xKraZx/Pol-Deck/hardware/Deck_Mainboard/Deck_Mainboard.kicad_pcb

## KiCad design hardware/Deck_Mainboard/Deck_Mainboard.kicad_pcb (2026-08-24)

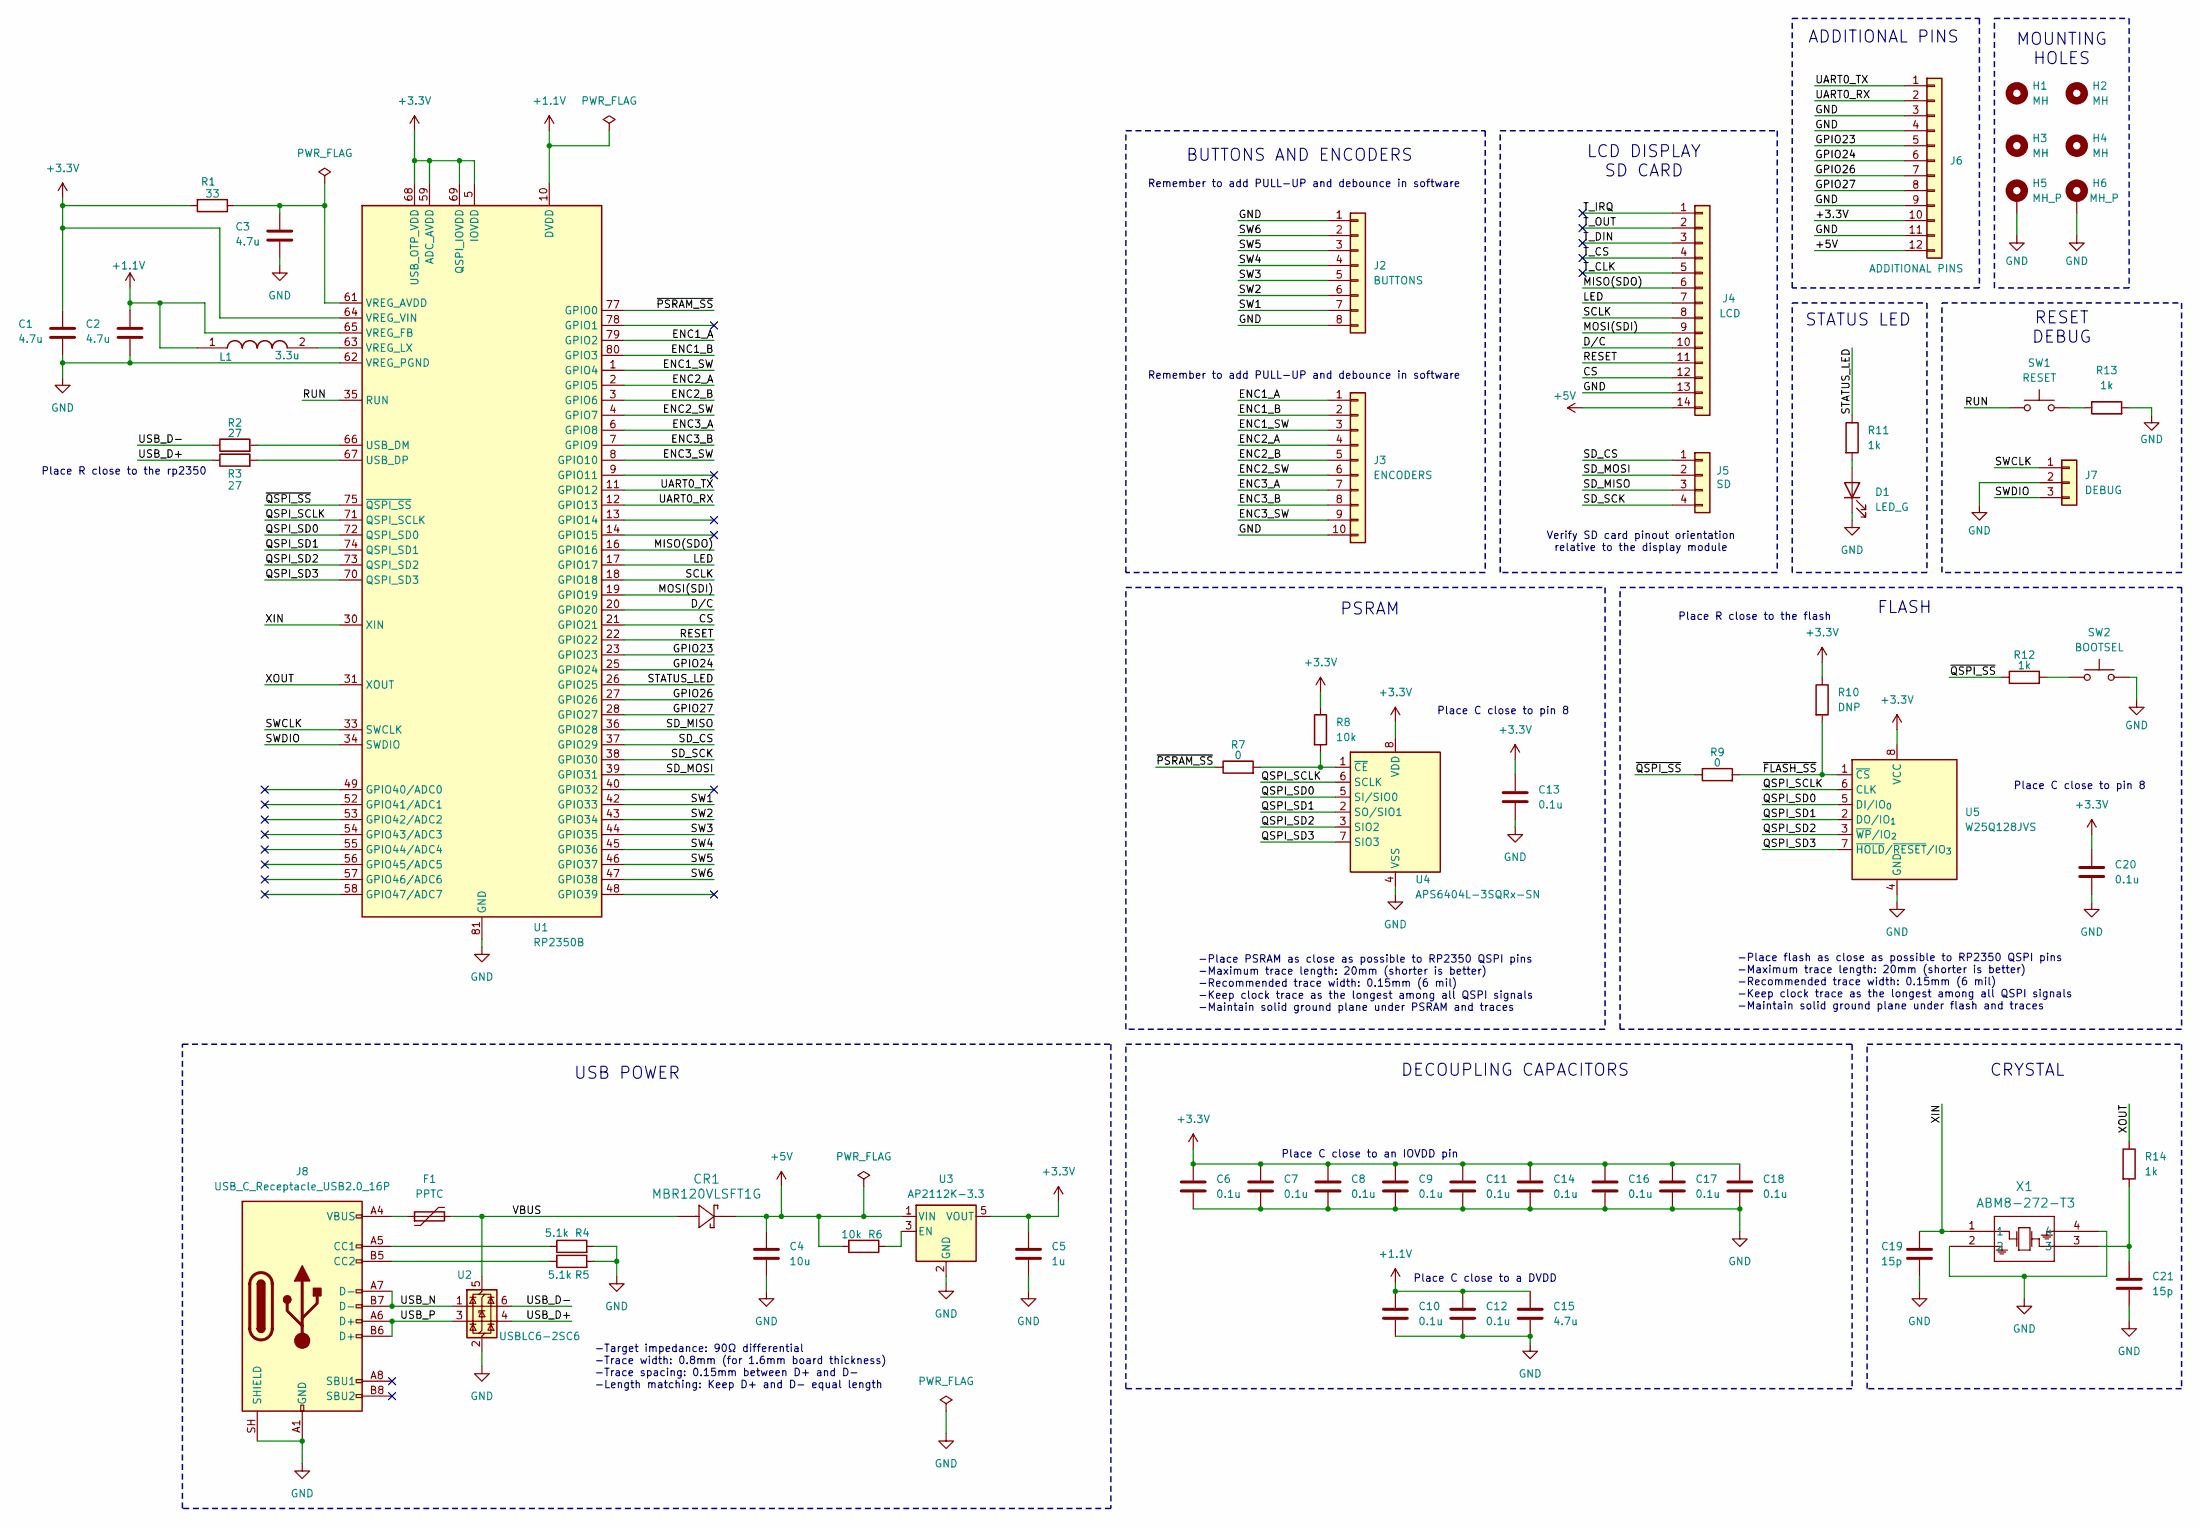
[picture p1: schematic Deck_Mainboard.kicad_sch]

Parts:
C1, C2, C3, C15: 4.7u; C_0402_1005Metric_Pad0.74x0.62mm_HandSolder
C4: 10u; C_0402_1005Metric_Pad0.74x0.62mm_HandSolder
C5: 1u; C_0402_1005Metric_Pad0.74x0.62mm_HandSolder
C6, C7, C8, C9, C10, C11, C12, C13, C14, C16, C17, C18, C20: 0.1u; C_0402_1005Metric_Pad0.74x0.62mm_HandSolder
C19, C21: 15p; C_0402_1005Metric_Pad0.74x0.62mm_HandSolder
CR1: MBR120VLSFT1G
D1: LED_G; LED_0603_1608Metric_Pad1.05x0.95mm_HandSolder
F1: PPTC; Fuse_1812_4532Metric_Pad1.30x3.40mm_HandSolder
H1, H2, H3, H4: MH; MountingHole_3.2mm_M3
H5, H6: MH_P; MountingHole_3.2mm_M3_Pad
J2: BUTTONS; PinHeader_1x08_P2.54mm_Vertical
J3: ENCODERS; PinHeader_1x10_P2.54mm_Vertical
J4: LCD; PinHeader_1x14_P2.54mm_Vertical
J5: SD; PinHeader_1x04_P2.54mm_Vertical
J6: ADDITIONAL PINS; PinHeader_1x12_P2.54mm_Vertical
J7: DEBUG; PinHeader_1x03_P2.54mm_Vertical
J8: USB_C_Receptacle_USB2.0_16P; USB_C_vertical
L1: 3.3u; AOTAB201610S3R3101T; Manufacturer_Part_Number AOTA-B201610S3R3-101-T
R1: 33; R_0402_1005Metric_Pad0.72x0.64mm_HandSolder
R2, R3: 27; R_0402_1005Metric_Pad0.72x0.64mm_HandSolder
R4, R5: 5.1k; R_0402_1005Metric_Pad0.72x0.64mm_HandSolder
R6, R8: 10k; R_0402_1005Metric_Pad0.72x0.64mm_HandSolder
R7, R9: 0; R_0402_1005Metric_Pad0.72x0.64mm_HandSolder
R10: DNP; R_0402_1005Metric_Pad0.72x0.64mm_HandSolder
R11, R12, R13, R14: 1k; R_0402_1005Metric_Pad0.72x0.64mm_HandSolder
SW1: RESET; SW_Push_1P1T_NO_E-Switch_TL3301NxxxxxG
SW2: BOOTSEL; SW_Push_1P1T_NO_E-Switch_TL3301NxxxxxG
U1: RP2350B; QFN-80-1EP_10x10mm_P0.4mm_EP3.4x3.4mm
U2: USBLC6-2SC6; SOT-23-6
U3: AP2112K-3.3; SOT-23-5
U4: APS6404L-3SQRx-SN; SOIC-8_3.9x4.9mm_P1.27mm
U5: W25Q128JVS; SOIC-8_5.3x5.3mm_P1.27mm
X1: ABM8-272-T3; ABM8-272-T3_ABR

Connections:
+1.1V: C2.1, C10.1, C12.1, C15.1, L1.1, U1.10 (DVDD), U1.32 (DVDD), U1.51 (DVDD), U1.65 (VREG_FB)
+3.3V: C1.1, C5.1, C6.1, C7.1, C8.1, C9.1, C11.1, C13.1, C14.1, C16.1, C17.1, C18.1, C20.1, J6.10, R1.2, R8.1, R10.1, U1.5 (IOVDD), U1.15 (IOVDD), U1.24 (IOVDD), U1.29 (IOVDD), U1.41 (IOVDD), U1.50 (IOVDD), U1.59 (ADC_AVDD), U1.60 (IOVDD), U1.64 (VREG_VIN), U1.68 (USB_OTP_VDD), U1.69 (QSPI_IOVDD), U1.76 (IOVDD), U3.5 (VOUT), U4.8 (VDD), U5.8 (VCC)
+5V: C4.1, CR1.1, J4.14, J6.12, R6.2, U3.1 (VIN)
/CS: J4.12, U1.21 (GPIO21)
/D/C: J4.10, U1.20 (GPIO20)
/ENC1_A: J3.1, U1.79 (GPIO2)
/ENC1_B: J3.2, U1.80 (GPIO3)
/ENC1_SW: J3.3, U1.1 (GPIO4)
/ENC2_A: J3.4, U1.2 (GPIO5)
/ENC2_B: J3.5, U1.3 (GPIO6)
/ENC2_SW: J3.6, U1.4 (GPIO7)
/ENC3_A: J3.7, U1.6 (GPIO8)
/ENC3_B: J3.8, U1.7 (GPIO9)
/ENC3_SW: J3.9, U1.8 (GPIO10)
/GPIO23: J6.5, U1.23 (GPIO23)
/GPIO24: J6.6, U1.25 (GPIO24)
/GPIO26: J6.7, U1.27 (GPIO26)
/GPIO27: J6.8, U1.28 (GPIO27)
/LED: J4.7, U1.17 (GPIO17)
/MISO(SDO): J4.6, U1.16 (GPIO16)
/MOSI(SDI): J4.9, U1.19 (GPIO19)
/QSPI_SCLK: U1.71 (QSPI_SCLK), U4.6 (SCLK), U5.6 (CLK)
/QSPI_SD0: U1.72 (QSPI_SD0), U4.5 (SI/SIO0), U5.5 (DI/IO_{0})
/QSPI_SD1: U1.74 (QSPI_SD1), U4.2 (SO/SIO1), U5.2 (DO/IO_{1})
/QSPI_SD2: U1.73 (QSPI_SD2), U4.3 (SIO2), U5.3 (~WP/IO_{2})
/QSPI_SD3: U1.70 (QSPI_SD3), U4.7 (SIO3), U5.7 (~HOLD/~RESET/IO_{3})
/RESET: J4.11, U1.22 (GPIO22)
/RUN: SW1.1, U1.35 (RUN)
/SCLK: J4.8, U1.18 (GPIO18)
/SD_CS: J5.1, U1.37 (GPIO29)
/SD_MISO: J5.3, U1.36 (GPIO28)
/SD_MOSI: J5.2, U1.39 (GPIO31)
/SD_SCK: J5.4, U1.38 (GPIO30)
/STATUS_LED: R11.1, U1.26 (GPIO25)
/SW1: J2.7, U1.42 (GPIO33)
/SW2: J2.6, U1.43 (GPIO34)
/SW3: J2.5, U1.44 (GPIO35)
/SW4: J2.4, U1.45 (GPIO36)
/SW5: J2.3, U1.46 (GPIO37)
/SW6: J2.2, U1.47 (GPIO38)
/SWCLK: J7.1, U1.33 (SWCLK)
/SWDIO: J7.3, U1.34 (SWDIO)
/T_CLK: J4.5
/T_CS: J4.4
/T_DIN: J4.3
/T_IRQ: J4.1
/T_OUT: J4.2
/UART0_RX: J6.2, U1.12 (GPIO13)
/UART0_TX: J6.1, U1.11 (GPIO12)
/USB_D+: R3.1, U2.4 (I/O2)
/USB_D-: R2.1, U2.6 (I/O1)
/USB_N: J8.A7 (D-), J8.B7 (D-), U2.1 (I/O1)
/USB_P: J8.A6 (D+), J8.B6 (D+), U2.3 (I/O2)
/VBUS: CR1.2, F1.2, U2.5 (VBUS)
/XIN: C19.1, U1.30 (XIN), X1.1
/XOUT: R14.1, U1.31 (XOUT)
/~FLASH_SS: R9.2, R10.2, U5.1 (~CS)
/~PSRAM_SS: R7.1, U1.77 (GPIO0)
/~QSPI_SS: R9.1, R12.1, U1.75 (~QSPI_SS)
GND: C1.2, C2.2, C3.2, C4.2, C5.2, C6.2, C7.2, C8.2, C9.2, C10.2, C11.2, C12.2, C13.2, C14.2, C15.2, C16.2, C17.2, C18.2, C19.2, C20.2, C21.2, D1.1 (K), H5.1 (1_1), H6.1 (1_1), J2.1, J2.8, J3.10, J4.13, J6.3, J6.4, J6.9, J6.11, J7.2, J8.A1 (GND), J8.A12 (GND), J8.B1 (GND), J8.B12 (GND), J8.SH (SHIELD), R4.2, R5.2, R13.2, SW2.2, U1.62 (VREG_PGND), U1.81 (GND), U2.2 (GND), U3.2 (GND), U4.4 (VSS), U5.4 (GND), X1.2, X1.4
unnamed: C21.1, R14.2, X1.3
unnamed: D1.2 (A), R11.2
unnamed: F1.1, J8.A4 (VBUS), J8.A9 (VBUS), J8.B4 (VBUS), J8.B9 (VBUS)
unnamed: J8.A5 (CC1), R4.1
unnamed: J8.B5 (CC2), R5.1
unnamed: R12.2, SW2.1
unnamed: R13.1, SW1.2
unnamed: R2.2, U1.66 (USB_DM)
unnamed: R3.2, U1.67 (USB_DP)
unnamed: C3.1, R1.1, U1.61 (VREG_AVDD)
unnamed: L1.2, U1.63 (VREG_LX)
unnamed: R6.1, U3.3 (EN)
unnamed: R7.2, R8.2, U4.1 (~CE)

Notes on the sheet:
-Place PSRAM as close as possible to RP2350 QSPI pins -Maximum trace length: 20mm (shorter is better) -Recommended trace width: 0.15mm (6 mil) -Keep clock trace as the longest among all QSPI signals -Maintain solid ground plane under PSRAM and traces
ADDITIONAL PINS
USB POWER
LCD DISPLAY SD CARD
BUTTONS AND ENCODERS
Place R close to the rp2350
Verify SD card pinout orientation relative to the display module
CRYSTAL
Place C close to a DVDD
FLASH
PSRAM
Place R close to the flash
RESET DEBUG
-Place flash as close as possible to RP2350 QSPI pins -Maximum trace length: 20mm (shorter is better) -Recommended trace width: 0.15mm (6 mil) -Keep clock trace as the longest among all QSPI signals -Maintain solid ground plane under flash and traces
MOUNTING HOLES
Remember to add PULL-UP and debounce in software
Place C close to pin 8
DECOUPLING CAPACITORS
-Target impedance: 90Ω differential -Trace width: 0.8mm (for 1.6mm board thickness) -Trace spacing: 0.15mm between D+ and D- -Length matching: Keep D+ and D- equal length
STATUS LED
Place C close to an IOVDD pin

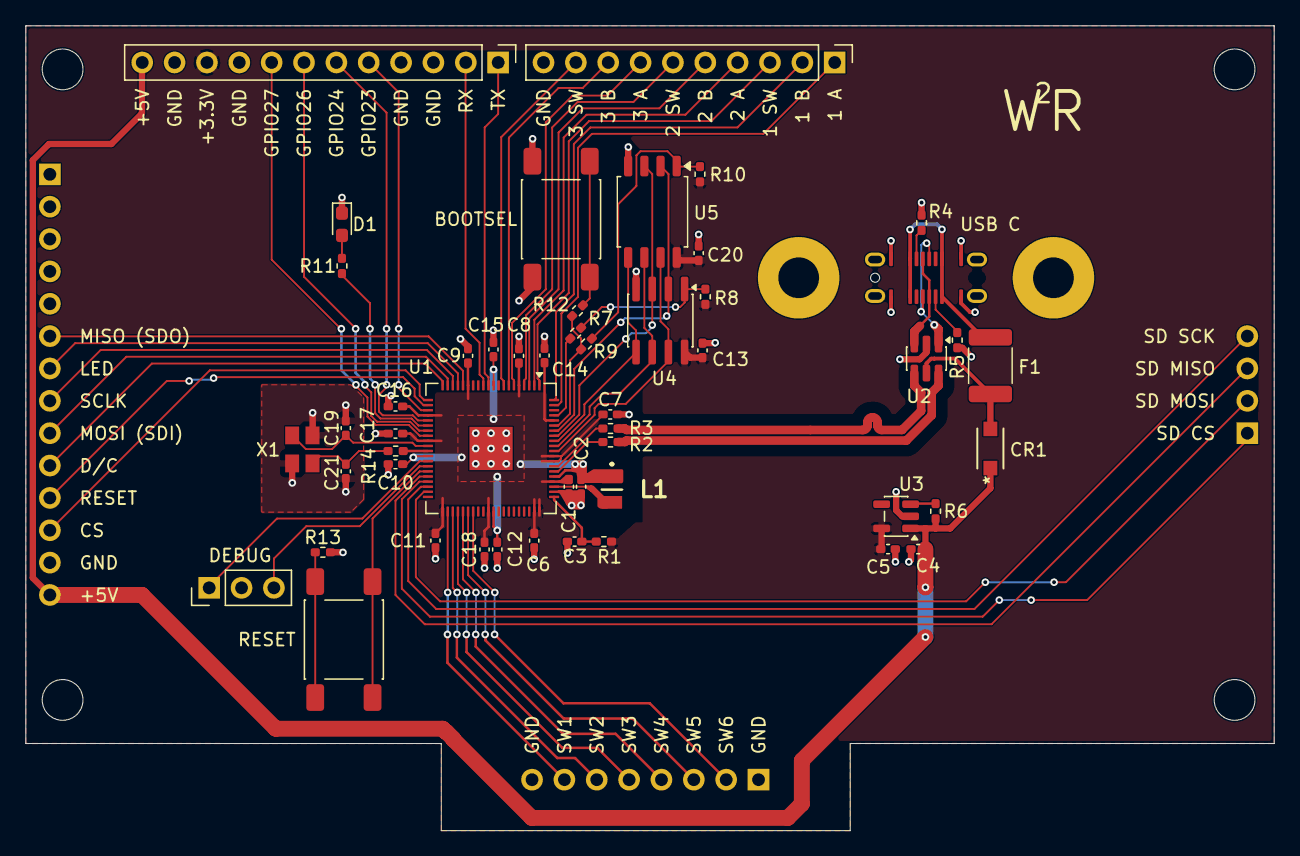
[picture p2: board Deck_Mainboard.kicad_pcb from above]

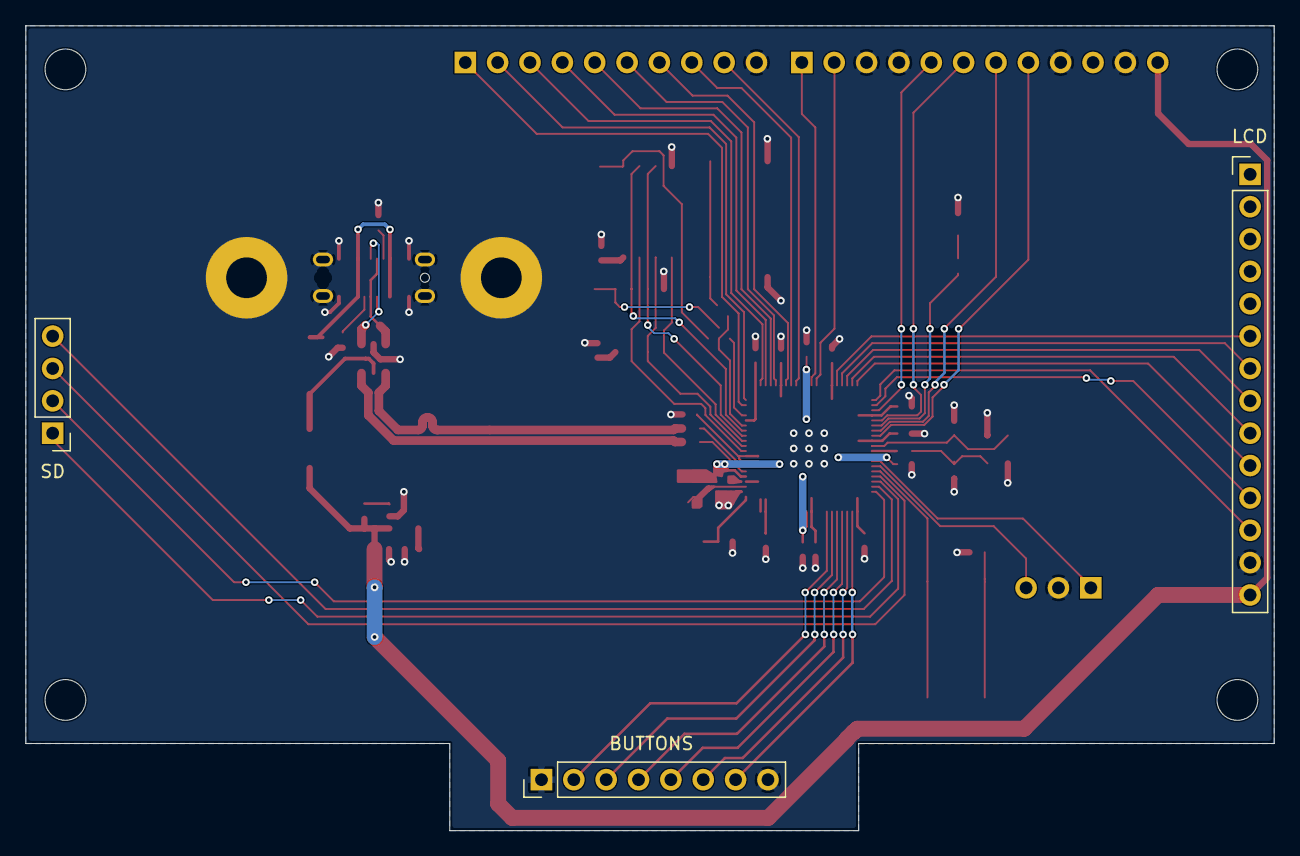
[picture p3: board Deck_Mainboard.kicad_pcb from below]

Board: 2 copper layers, 98.0 x 63.2 mm, 60 parts (3 on the bottom side), 68 nets.
