xKraZx/Pol-Deck/hardware/Deck_ButtonBoard/ButtonBoard/ButtonBoard.kicad_pcb

## KiCad design hardware/Deck_ButtonBoard/ButtonBoard/ButtonBoard.kicad_pcb (2026-08-24)

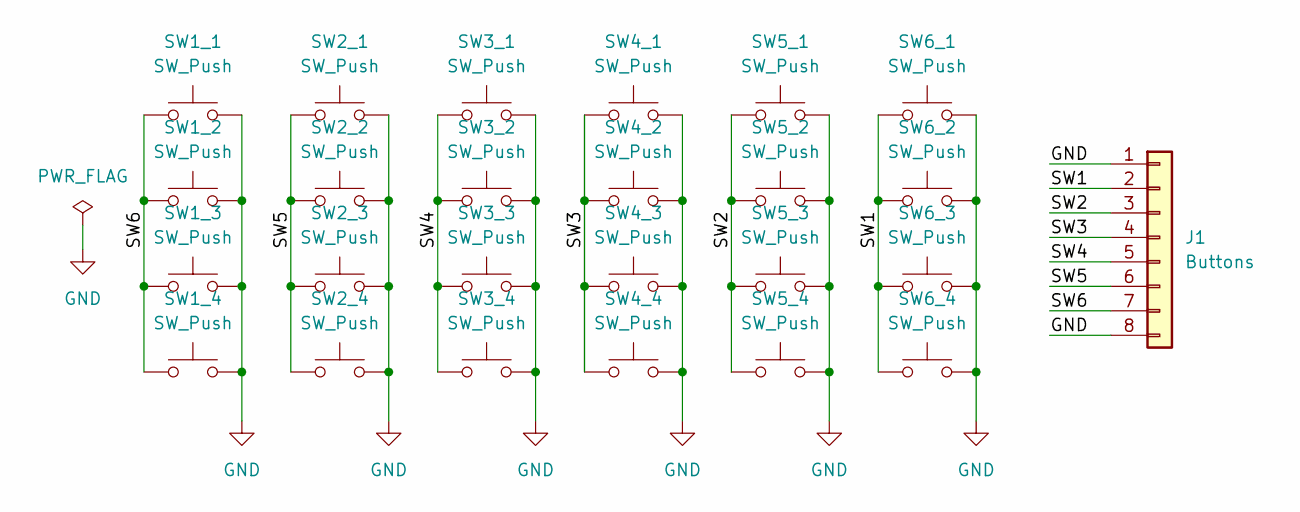
[picture p4: schematic ButtonBoard.kicad_sch]

Parts:
J1: Buttons; PinSocket_1x08_P2.54mm_Vertical
SW1_1, SW1_2, SW1_3, SW1_4, SW2_1, SW2_2, SW2_3, SW2_4, SW3_1, SW3_2, SW3_3, SW3_4, SW4_1, SW4_2, SW4_3, SW4_4, SW5_1, SW5_2, SW5_3, SW5_4, SW6_1, SW6_2, SW6_3, SW6_4: SW_Push; SW_Tactile_SPST_NO_Straight_CK_PTS636Sx25SMTRLFS

Connections:
/SW1: J1.2, SW6_1.1, SW6_2.1, SW6_3.1, SW6_4.1
/SW2: J1.3, SW5_1.1, SW5_2.1, SW5_3.1, SW5_4.1
/SW3: J1.4, SW4_1.1, SW4_2.1, SW4_3.1, SW4_4.1
/SW4: J1.5, SW3_1.1, SW3_2.1, SW3_3.1, SW3_4.1
/SW5: J1.6, SW2_1.1, SW2_2.1, SW2_3.1, SW2_4.1
/SW6: J1.7, SW1_1.1, SW1_2.1, SW1_3.1, SW1_4.1
GND: J1.1, J1.8, SW1_1.2, SW1_2.2, SW1_3.2, SW1_4.2, SW2_1.2, SW2_2.2, SW2_3.2, SW2_4.2, SW3_1.2, SW3_2.2, SW3_3.2, SW3_4.2, SW4_1.2, SW4_2.2, SW4_3.2, SW4_4.2, SW5_1.2, SW5_2.2, SW5_3.2, SW5_4.2, SW6_1.2, SW6_2.2, SW6_3.2, SW6_4.2

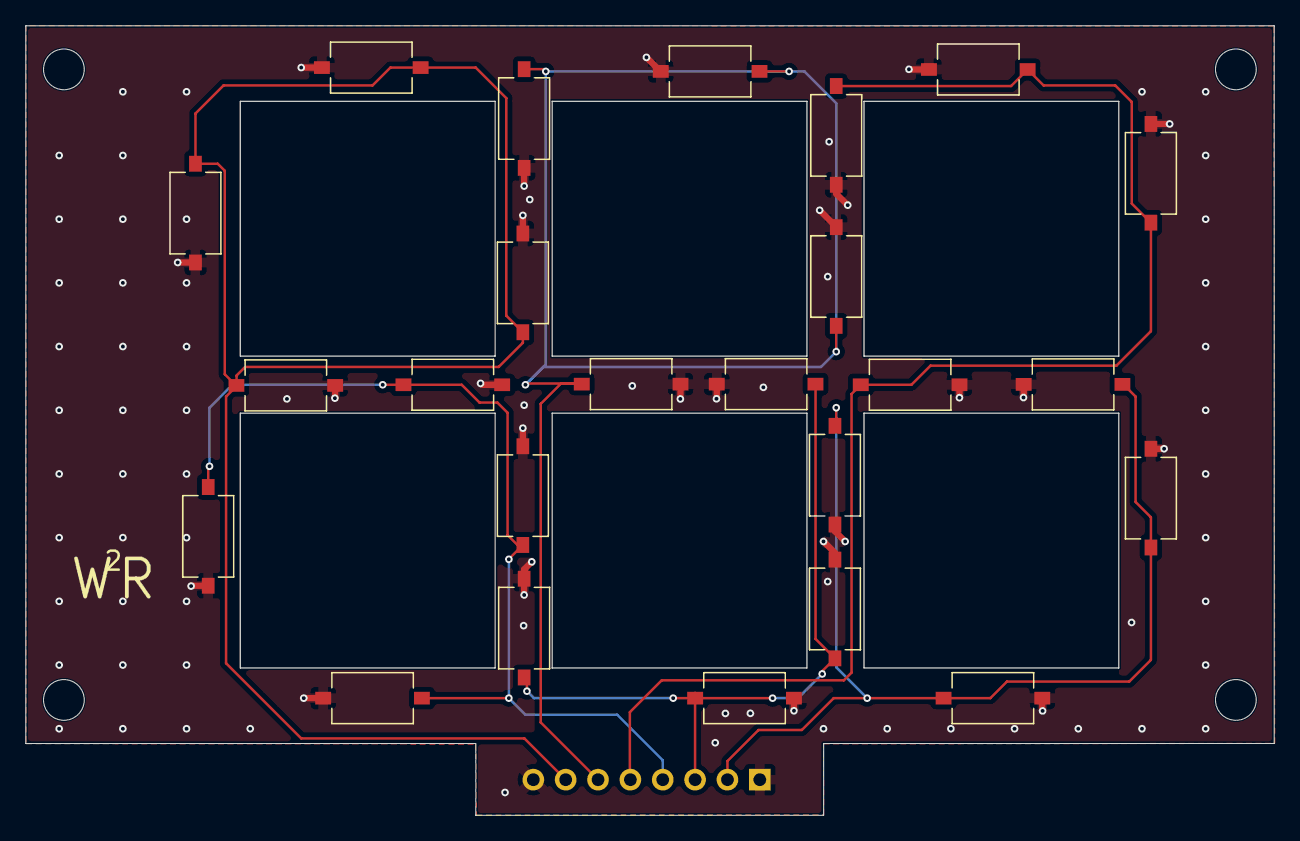
[picture p5: board ButtonBoard.kicad_pcb from above]

Board: 2 copper layers, 98.0 x 62.0 mm, 29 parts (1 on the bottom side), 7 nets.

Other parts of the board:
H1, H2, H3, H4: MH; MountingHole_3.2mm_M3
