xKraZx/Pol-Deck/firmware/board/pol_deck.h

// clang-format off

#ifndef _BOARDS_POL_DECK_CORE_H
#define _BOARDS_POL_DECK_CORE_H

// cppcheck-suppress unknownMacro
pico_board_cmake_set(PICO_PLATFORM, rp2350-arm-s)

// --- BOARD SPECIFIC ---
#define POL_DECK_PSRAM_CS_PIN 0

// --- ILI9488 ---
#define ILI9488_SPI spi0
#define ILI9488_SPI_HZ 5000000

#define ILI9488_PIN_SCK 18
#define ILI9488_PIN_MOSI 19
#define ILI9488_PIN_CS 21
#define ILI9488_PIN_DC 20
#define ILI9488_PIN_RST 22
#define ILI9488_PIN_LED 17

#define ILI9488_PANEL_W 320
#define ILI9488_PANEL_H 480

#define ILI9488_DEFAULT_ROTATION 1

// --- UART ---
#ifndef PICO_DEFAULT_UART
#define PICO_DEFAULT_UART 0
#endif
#ifndef PICO_DEFAULT_UART_TX_PIN
#define PICO_DEFAULT_UART_TX_PIN 12
#endif
#ifndef PICO_DEFAULT_UART_RX_PIN
#define PICO_DEFAULT_UART_RX_PIN 13
#endif

// --- LED ---
#ifndef PICO_DEFAULT_LED_PIN
#define PICO_DEFAULT_LED_PIN 25
#endif

// --- I2C ---
#ifndef PICO_DEFAULT_I2C
#define PICO_DEFAULT_I2C 0
#endif
#ifndef PICO_DEFAULT_I2C_SDA_PIN
#define PICO_DEFAULT_I2C_SDA_PIN 8
#endif
#ifndef PICO_DEFAULT_I2C_SCL_PIN
#define PICO_DEFAULT_I2C_SCL_PIN 9
#endif

// --- SPI ---
#ifndef PICO_DEFAULT_SPI
#define PICO_DEFAULT_SPI 1
#endif
#ifndef PICO_DEFAULT_SPI_SCK_PIN
#define PICO_DEFAULT_SPI_SCK_PIN 30
#endif
#ifndef PICO_DEFAULT_SPI_TX_PIN
#define PICO_DEFAULT_SPI_TX_PIN 31
#endif
#ifndef PICO_DEFAULT_SPI_RX_PIN
#define PICO_DEFAULT_SPI_RX_PIN 28
#endif
#ifndef PICO_DEFAULT_SPI_CSN_PIN
#define PICO_DEFAULT_SPI_CSN_PIN 29
#endif

// --- FLASH ---
#define PICO_BOOT_STAGE2_CHOOSE_W25Q080 1

#ifndef PICO_FLASH_SPI_CLKDIV
#define PICO_FLASH_SPI_CLKDIV 2
#endif

pico_board_cmake_set_default(PICO_FLASH_SIZE_BYTES, (16 * 1024 * 1024))
#ifndef PICO_FLASH_SIZE_BYTES
#define PICO_FLASH_SIZE_BYTES (16 * 1024 * 1024)
#endif

// --- PSRAM ---
#ifndef PICO_PSRAM_CS_PIN
#define PICO_PSRAM_CS_PIN POL_DECK_PSRAM_CS_PIN
#endif

pico_board_cmake_set_default(PICO_PSRAM_SIZE_BYTES, (8 * 1024 * 1024))
#ifndef PICO_PSRAM_SIZE_BYTES
#define PICO_PSRAM_SIZE_BYTES (8 * 1024 * 1024)
#endif

// --- RP2350 VARIANT ---
// This means RP2350B.
#define PICO_RP2350A 0

pico_board_cmake_set_default(PICO_RP2350_A2_SUPPORTED, 1)
#ifndef PICO_RP2350_A2_SUPPORTED
#define PICO_RP2350_A2_SUPPORTED 1
#endif

#endif
