xKraZx/Pol-Deck/(commit log)

2026-08-15 hw: mainboard schematic design
    [Deck_Mainboard.kicad_pcb, Deck_Mainboard.kicad_sch]
2026-08-17 hw: initial pcb layout
    [Deck_Mainboard.kicad_pcb, Deck_Mainboard.kicad_sch]
2026-08-21 hw: connectors routing
    [Deck_Mainboard.kicad_pcb, Deck_Mainboard.kicad_sch]
2026-08-23 hw: add buttonboard init
2026-08-24 hw: pcbs complete
